Scrarf/PCB_For_FPGA_Path_Tracer/readme.md

# Work in progress!

PCB for [FPGA\_Path\_tracer](https://github.com/Scrarf/FPGA_Path_Tracer).

# Schematic

schematic

# Layout (WIP)

schematic
