Scrarf/PCB_For_FPGA_Path_Tracer/fpga_board.kicad_pcb

## KiCad design fpga_board.kicad_pcb (2026-03-17)

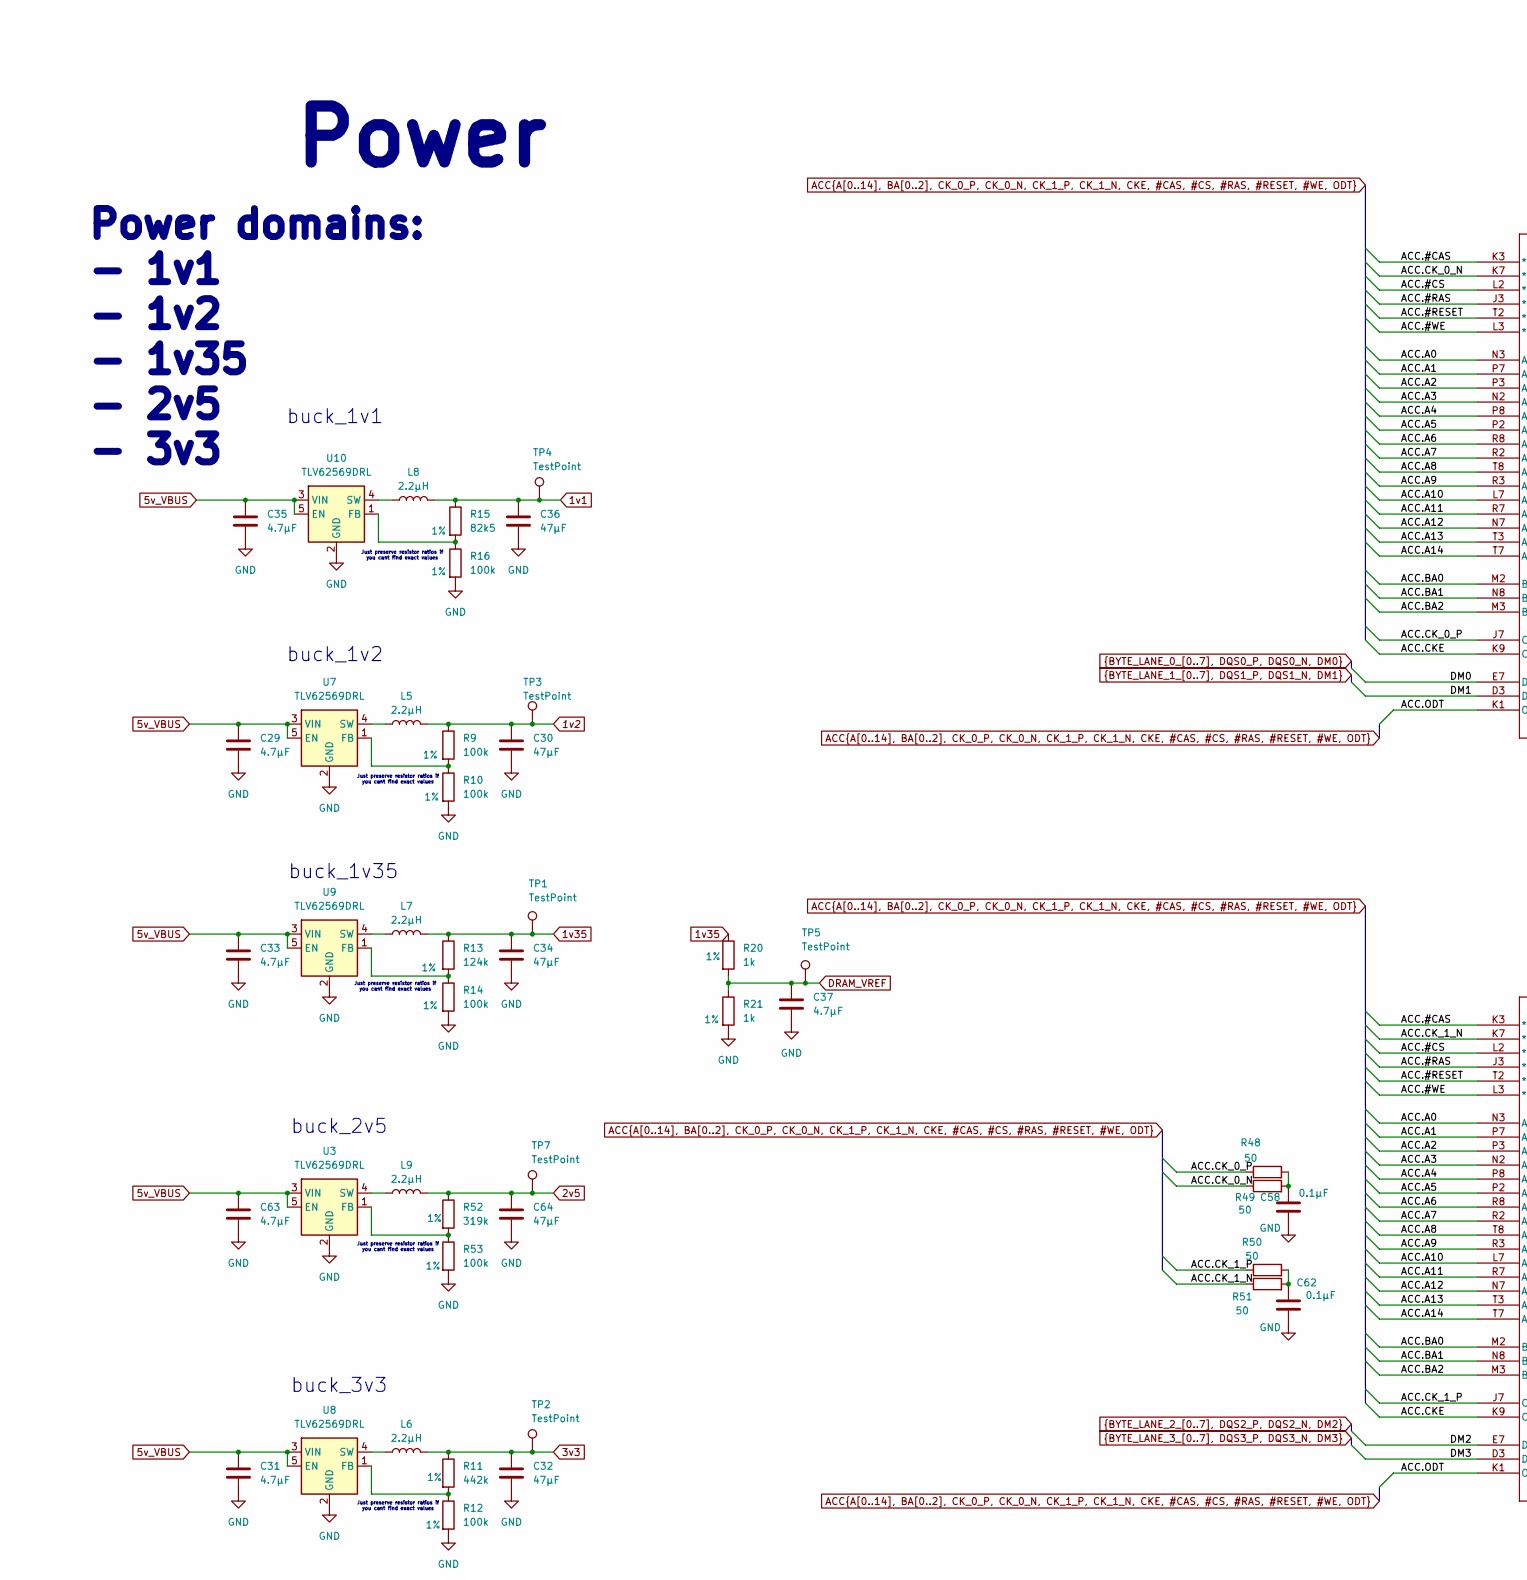
[picture p1: schematic fpga_board.kicad_sch, part in row 1, column 1]

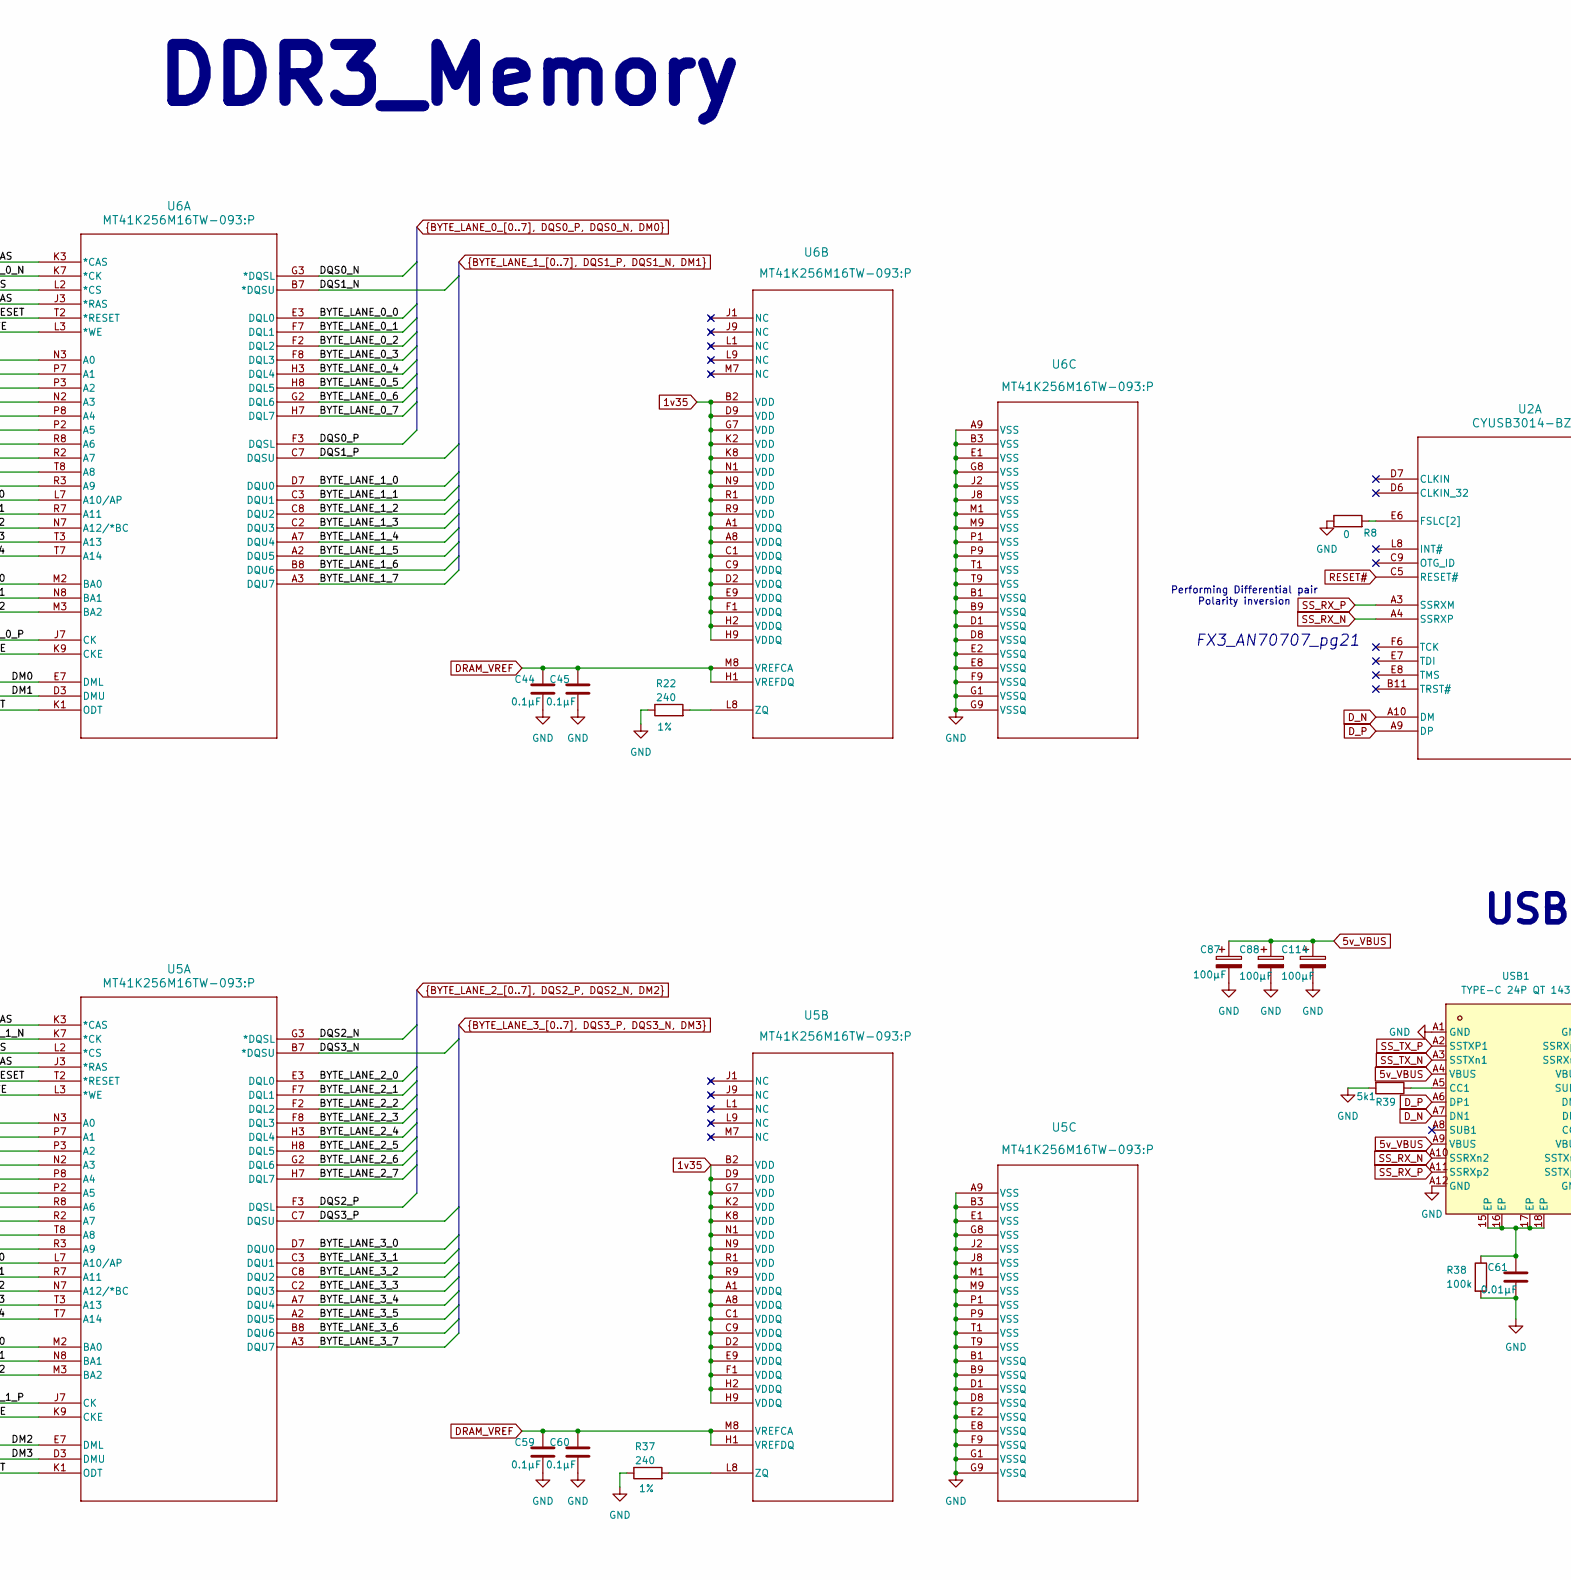
[picture p2: schematic fpga_board.kicad_sch, part in row 1, column 2]

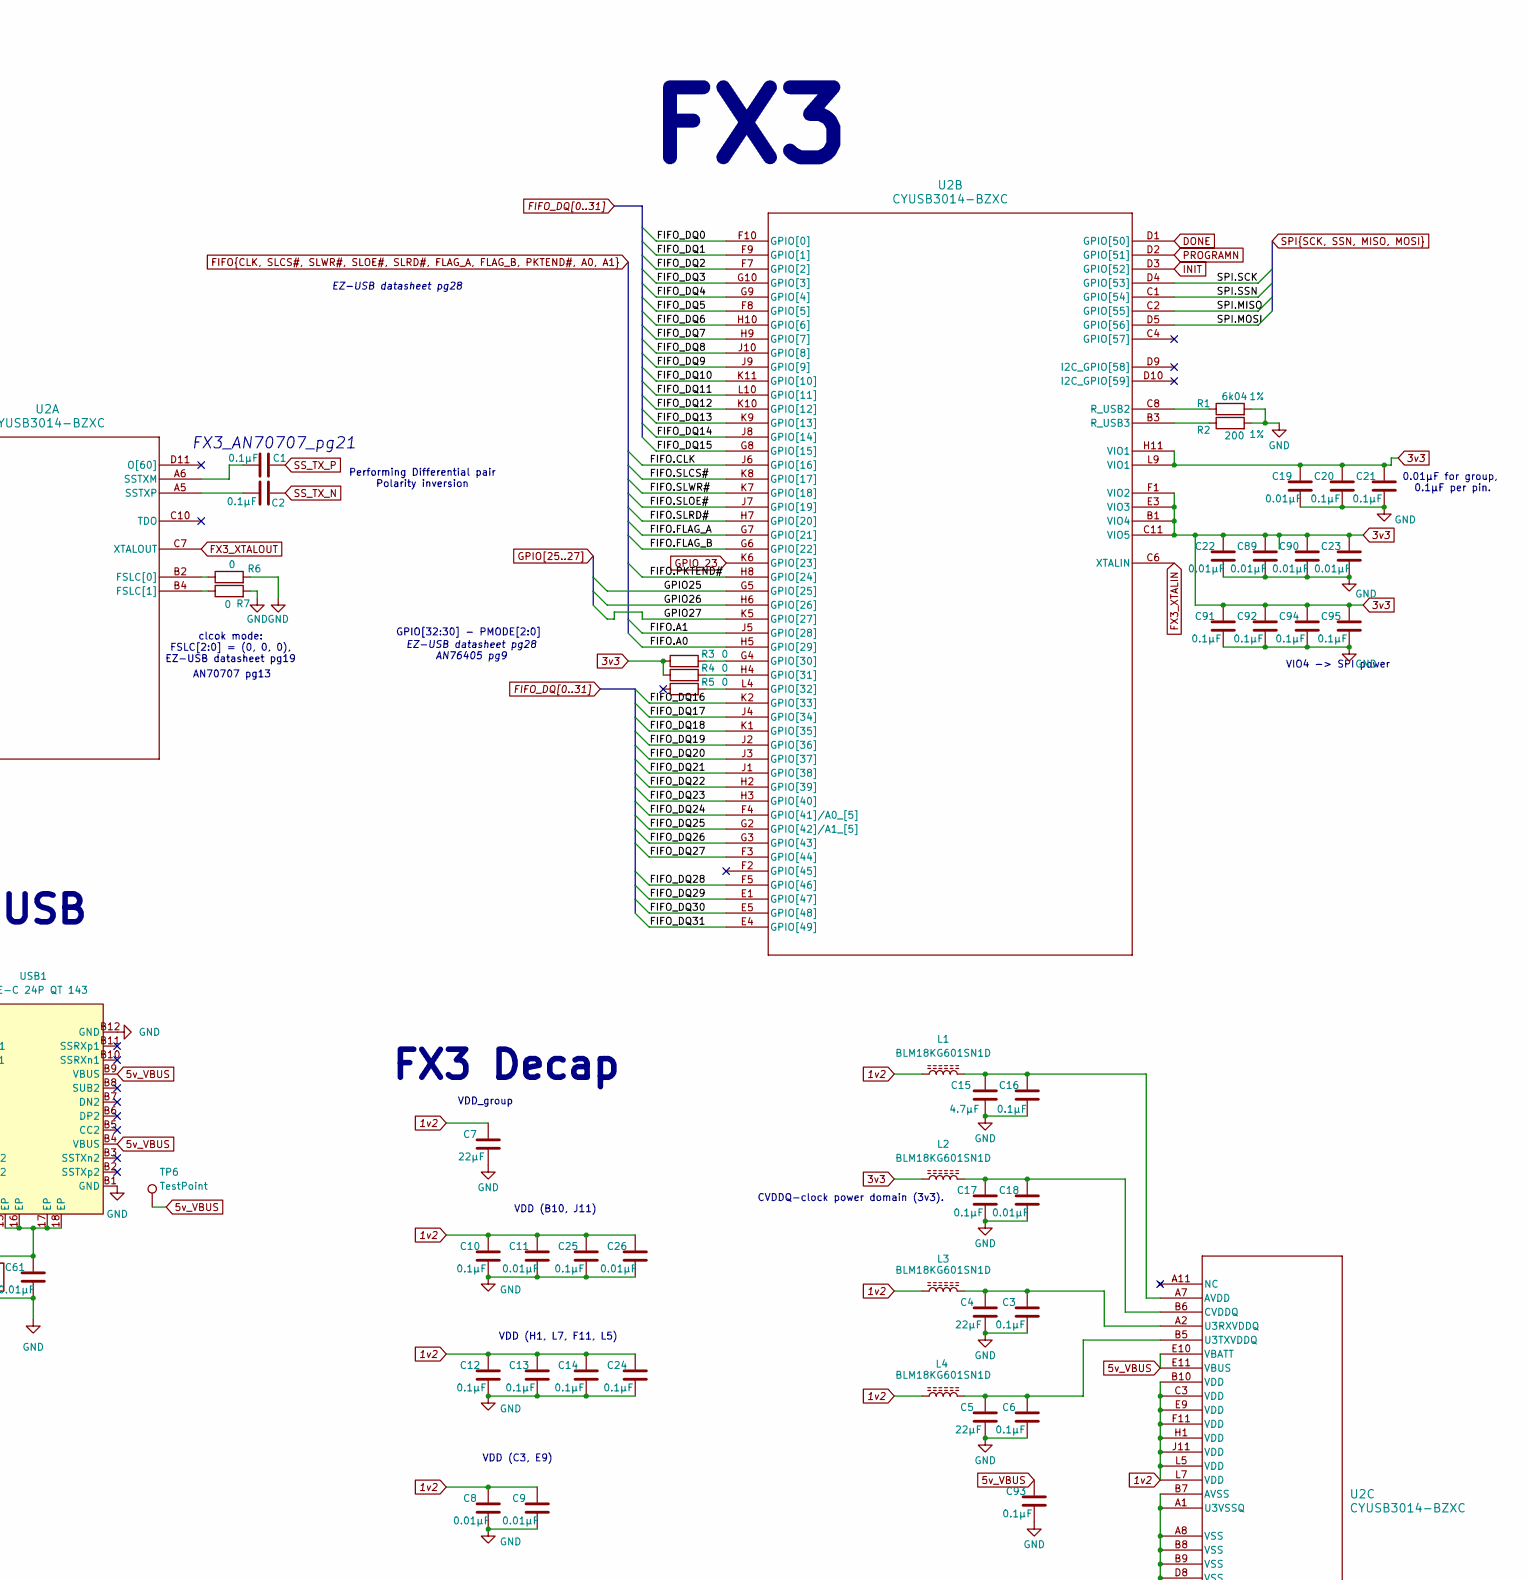
[picture p3: schematic fpga_board.kicad_sch, part in row 1, column 3]

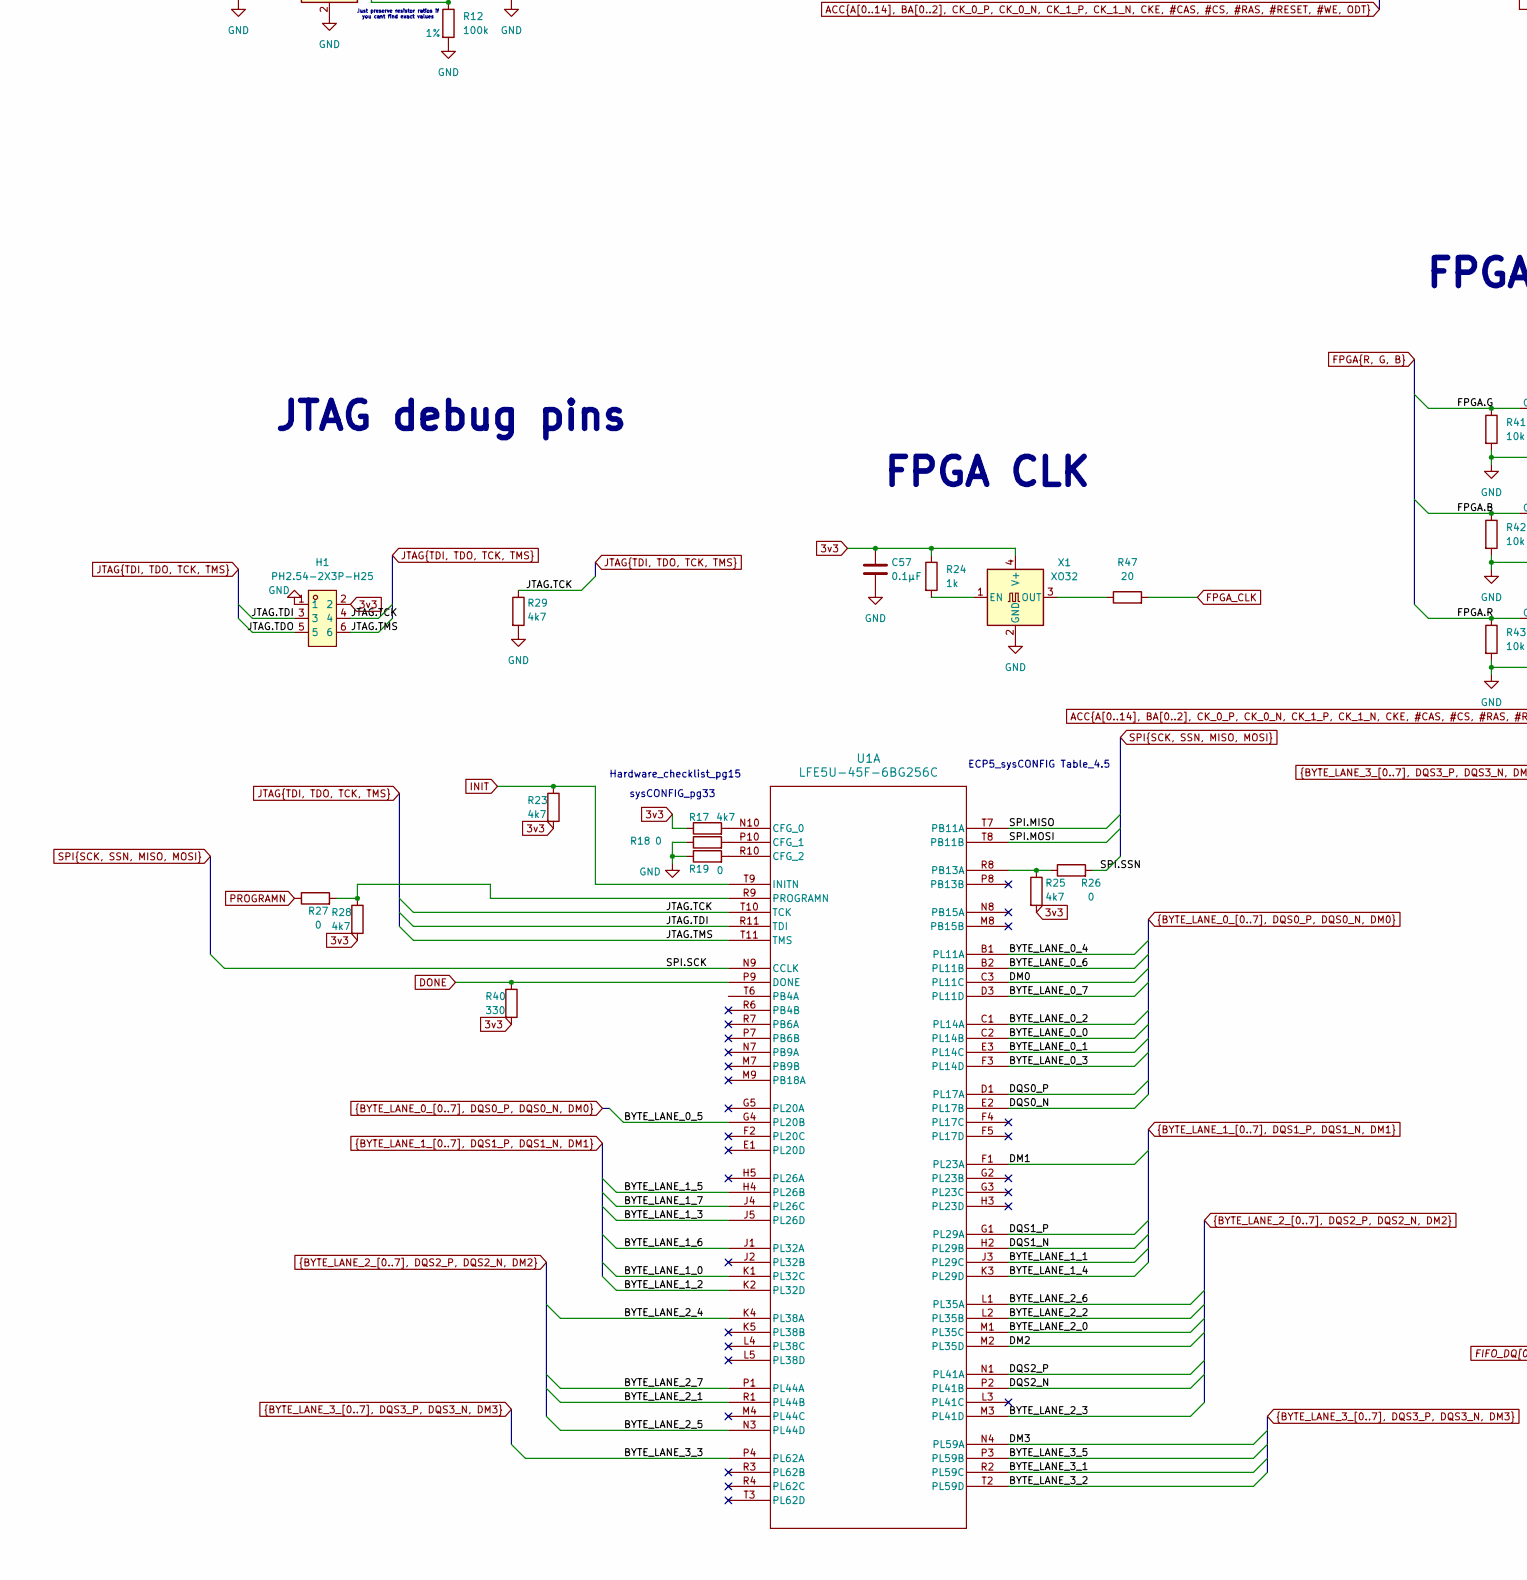
[picture p4: schematic fpga_board.kicad_sch, part in row 2, column 1]

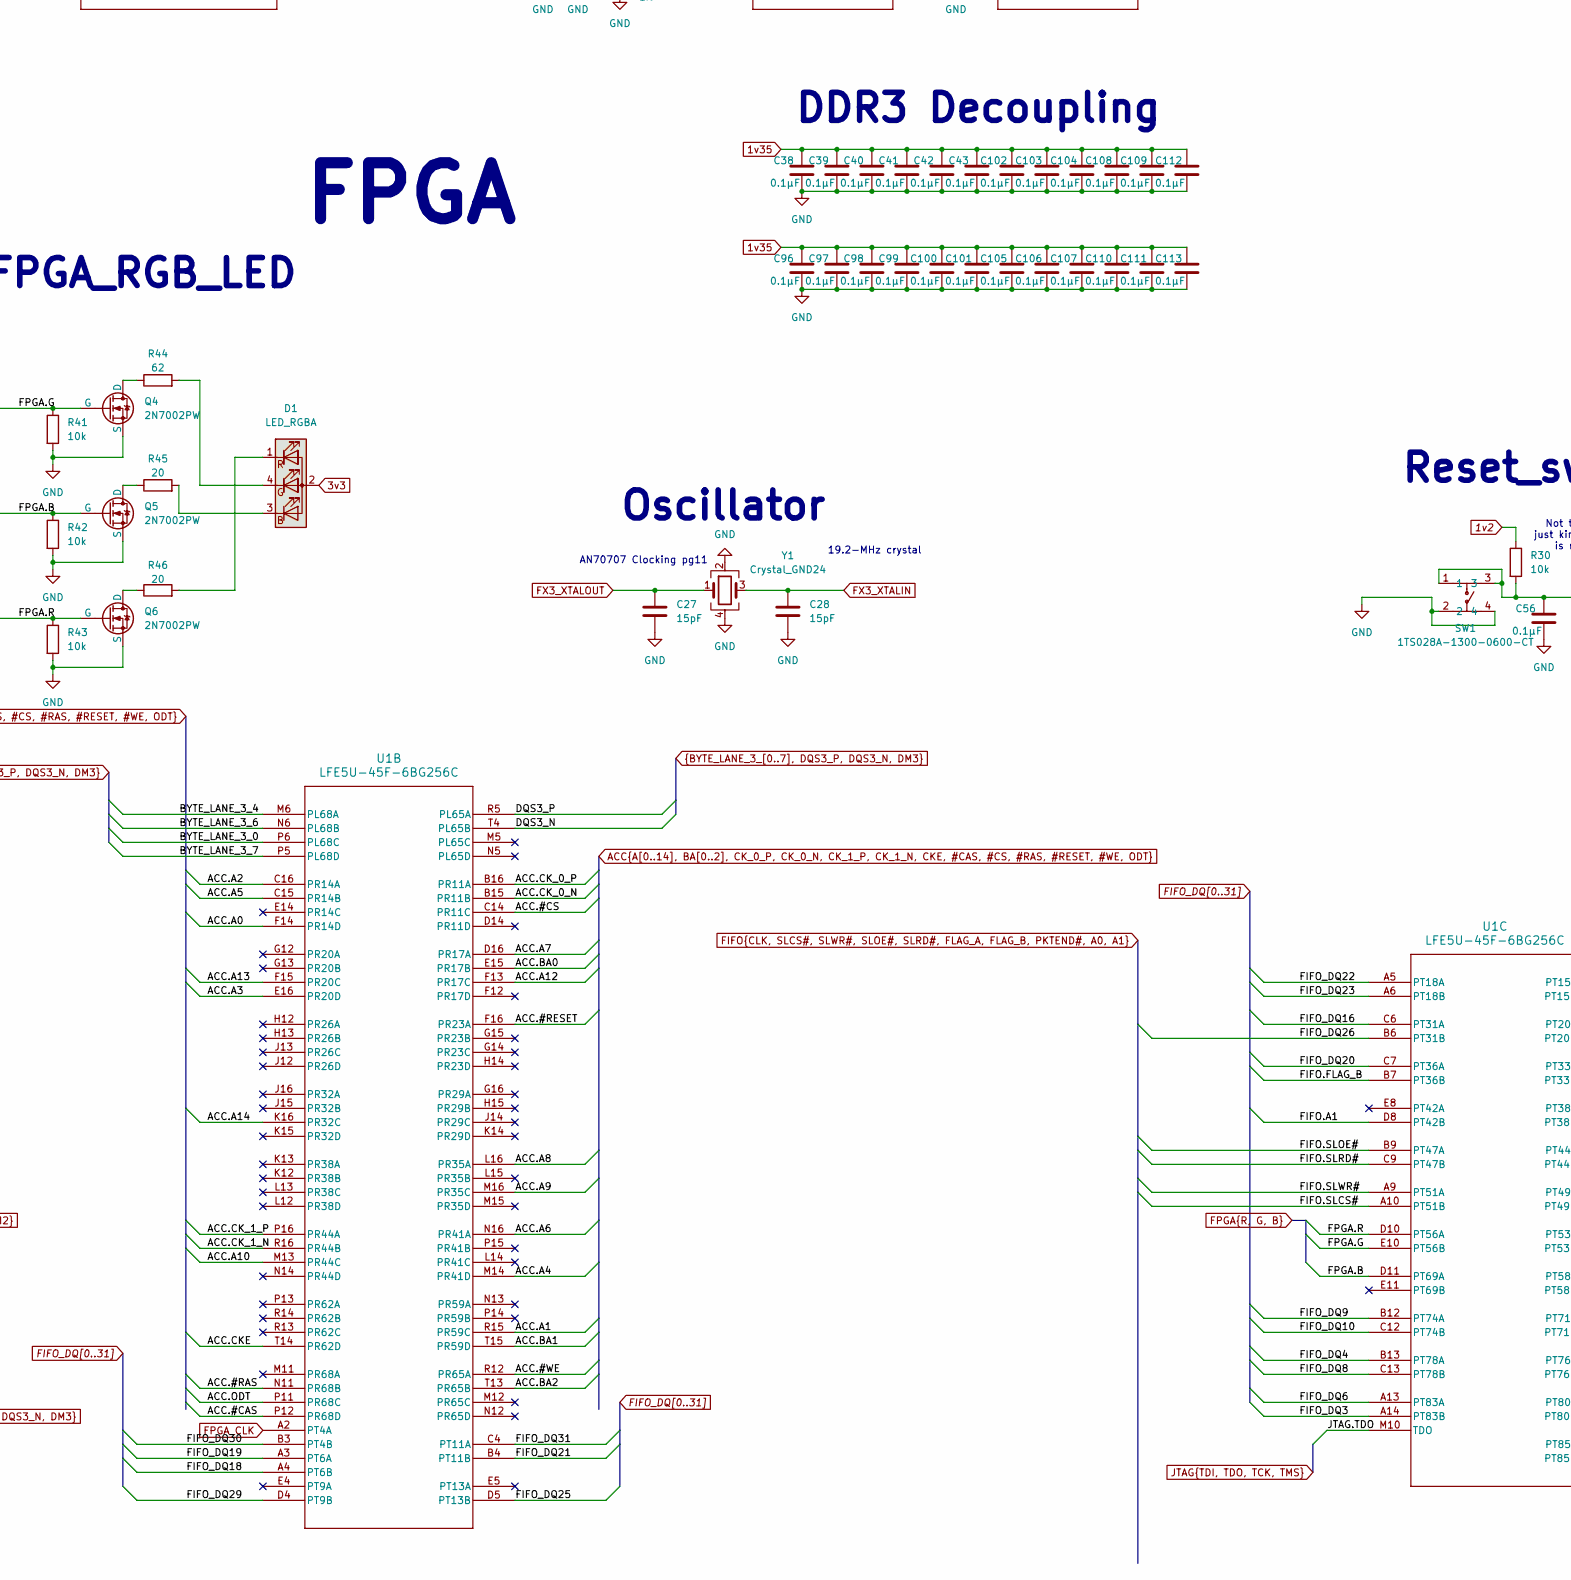
[picture p5: schematic fpga_board.kicad_sch, part in row 2, column 2]

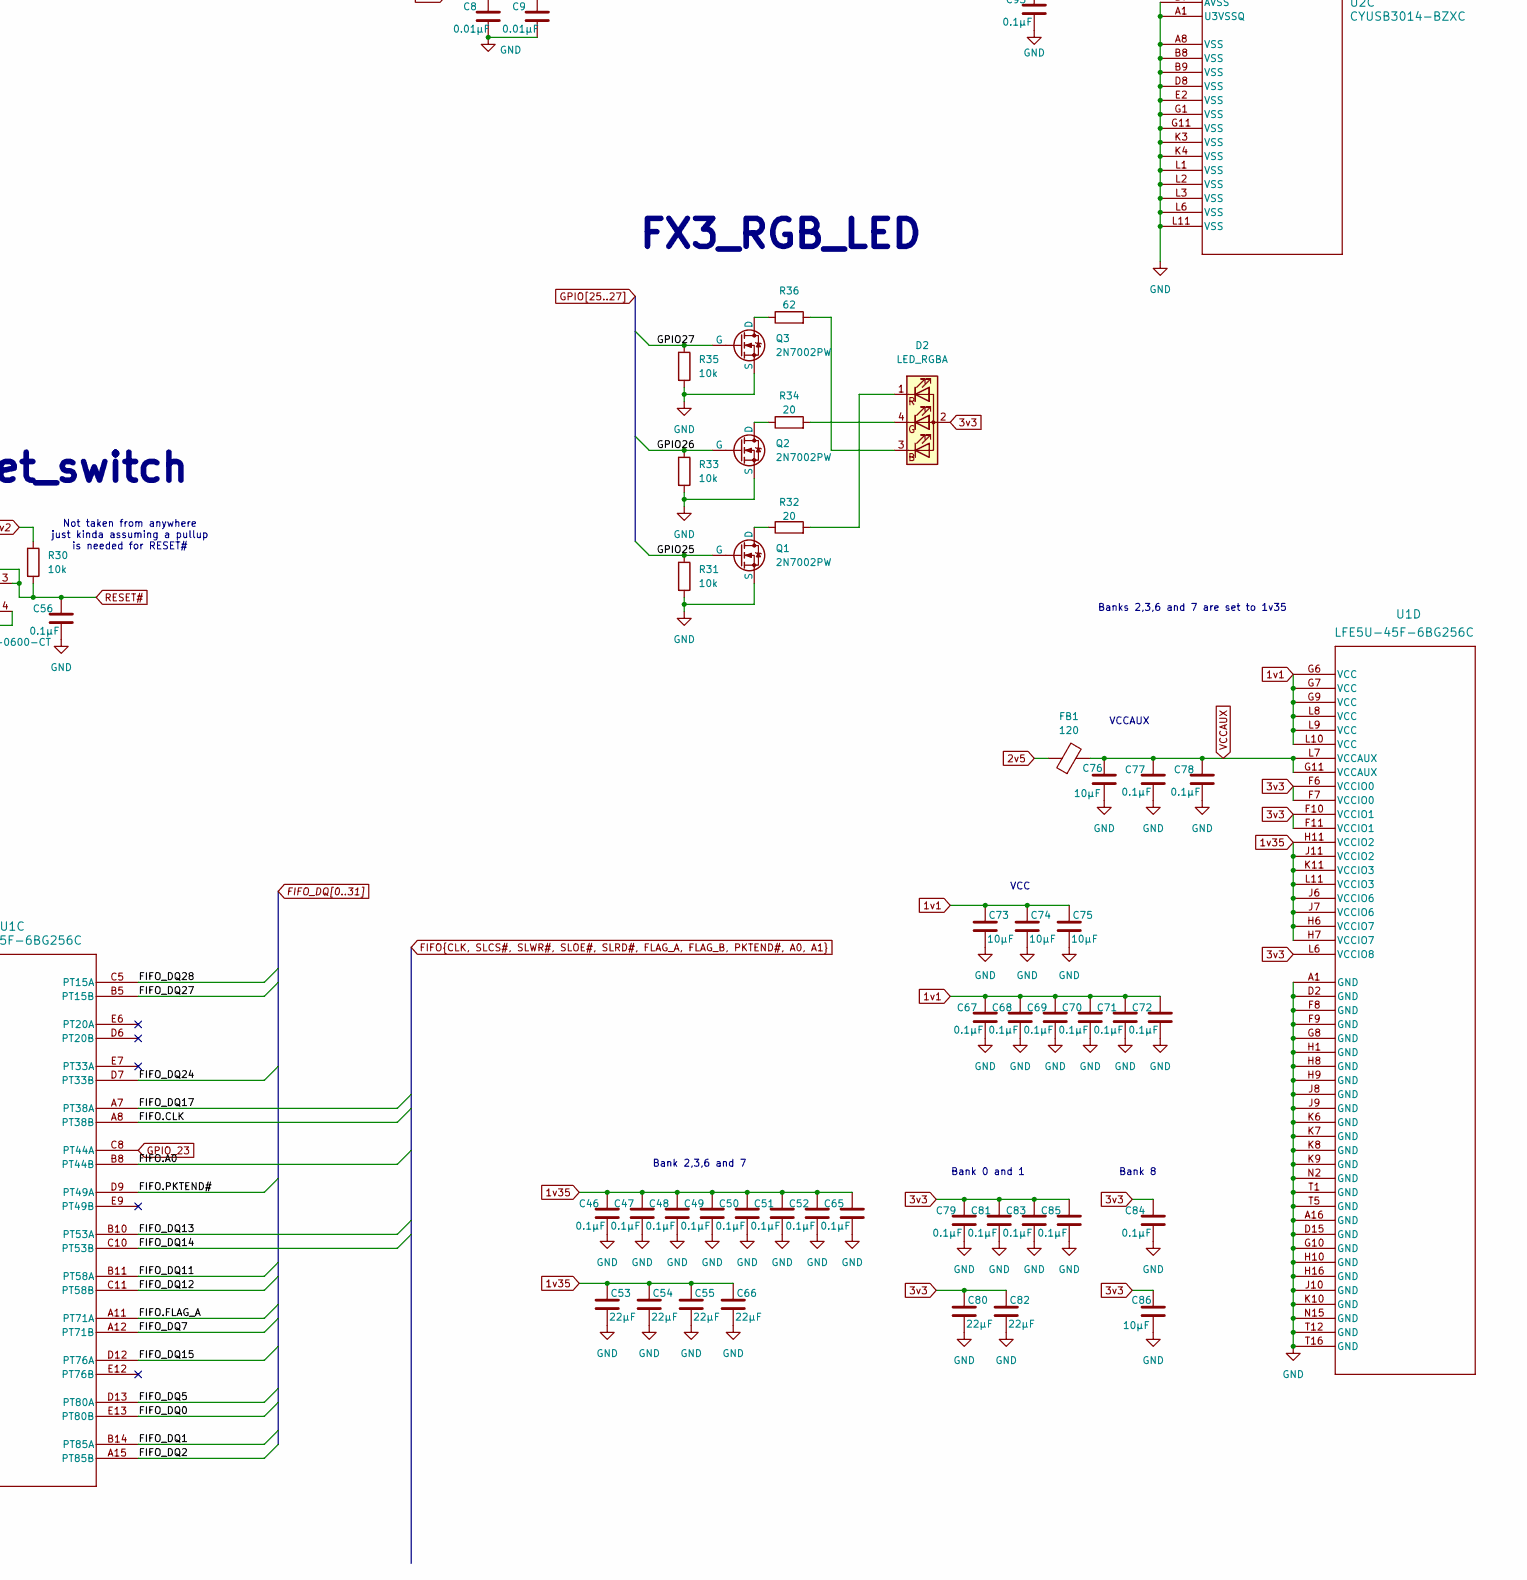
[picture p6: schematic fpga_board.kicad_sch, part in row 2, column 3]

Parts:
C1, C2, C3, C6, C10, C12, C13, C14, C16, C17, C20, C21, C24, C25, C38, C39, C40, C41, C42, C43, C44, C45, C46, C47, C48, C49, C50, C51, C52, C56, C57, C58, C59, C60, C62, C65, C67, C68, C69, C70, C71, C72, C77, C78, C79, C81, C83, C84, C85, C91, C92, C93, C94, C95, C96, C97, C98, C99, C100, C101, C102, C103, C104, C105, C106, C107, C108, C109, C110, C111, C112, C113: 0.1µF; C_0402_1005Metric; LCSC Part C60474
C4, C5, C7, C53, C54, C55, C66, C80, C82: 22µF; C_0603_1608Metric; LCSC Part C6119868
C8, C9, C11, C18, C19, C22, C23, C26, C61, C89, C90: 0.01µF; C_0402_1005Metric; LCSC Part C22435944
C15, C29, C31, C33, C35, C37, C63: 4.7µF; C_0402_1005Metric; LCSC Part C6119786
C27, C28: 15pF; C_0402_1005Metric; LCSC Part C5448865
C30, C32, C34, C36, C64: 47µF; C_0805_2012Metric; LCSC Part C19103846
C73, C74, C75, C76, C86: 10µF; C_0402_1005Metric; LCSC Part C315248
C87, C88, C114: 100μF; CP_Elec_6.3x5.4; LCSC Part C2887276
D1, D2: LED_RGBA; LED_Wurth_150044M155260; LCSC Part C22461780
FB1: 120; L_0603_1608Metric; LCSC Part C307770
H1: PH2.54-2X3P-H25; HDR-TH_6P-P2.54-V-M-R2-C3-S2.54-1; LCSC Part C42431837
L1, L2, L3, L4: BLM18KG601SN1D; L_0603_1608Metric; LCSC Part C85833
L5, L6, L7, L8, L9: 2.2µH; IND_VLS3015_TDK; LCSC Part C42924311
Q1, Q2, Q3, Q4, Q5, Q6: 2N7002PW; SOT-323_SC-70; LCSC Part C7379955
R1: 6k04; R_0402_1005Metric; LCSC Part C168240
R2: 200; R_0402_1005Metric; LCSC Part C49655161
R3, R4, R5, R6, R7, R8, R18, R19, R26, R27: 0; R_0402_1005Metric; LCSC Part C106231
R9, R10, R12, R14, R16, R38, R53: 100k; R_0603_1608Metric; LCSC Part C14675
R11: 442k; R_0603_1608Metric; LCSC Part C3013201
R13: 124k; R_0603_1608Metric; LCSC Part C3016392
R15: 82k5; R_0603_1608Metric; LCSC Part C2999460
R17, R23, R25, R28, R29: 4k7; R_0402_1005Metric; LCSC Part C3017492
R20, R21, R24: 1k; R_0603_1608Metric; LCSC Part C22548
R22, R37: 240; R_0603_1608Metric; LCSC Part C49653074
R30, R31, R33, R35, R41, R42, R43: 10k; R_0402_1005Metric; LCSC Part C51035904
R32, R34, R45, R46, R47: 20; R_0402_1005Metric; LCSC Part C3017453
R36, R44: 62; R_0402_1005Metric; LCSC Part C49653021
R39: 5k1; R_0402_1005Metric; LCSC Part C49652827
R40: 330; R_0402_1005Metric; LCSC Part C2906929
R48, R49, R50, R51: 50; R_0402_1005Metric; LCSC Part C853312
R52: 319k; R_0603_1608Metric; LCSC Part C20165692
SW1: 1TS028A-1300-0600-CT; SW-SMD_4P-L2.8-W1.9-P1.20-LS3.0_1TS028A; LCSC Part C481983
TP1, TP2, TP3, TP4, TP5, TP6, TP7: TestPoint; TestPoint_Pad_D1.0mm
U1: LFE5U-45F-6BG256C; caBGA256_LAT; LCSC Part C1550834
U2: CYUSB3014-BZXC; TFBGA-121_10x10mm_Layout11x11_P0.8mm; LCSC Part C462526
U3, U7, U8, U9, U10: TLV62569DRL; SOT-563; LCSC Part C163217
U5, U6: MT41K256M16TW-093:P; Micron_FBGA-96_9x14mm_Layout9x16_P0.8mm; LCSC Part C2064402
USB1: TYPE-C 24P QT 143; TYPE-C-SMD_C9900025773; LCSC Part C5156605
X1: XO32; Crystal_SMD_5032-4Pin_5.0x3.2mm; LCSC Part C50345411
Y1: Crystal_GND24; Crystal_SMD_2520-4Pin_2.5x2.0mm; LCSC Part C7206296

Connections:
1v1: C36.1, C67.2, C68.2, C69.2, C70.2, C71.2, C72.2, C73.1, C74.1, C75.1, L8.2, R15.1, TP4.1, U1.G6 (VCC), U1.G7 (VCC), U1.G9 (VCC), U1.L8 (VCC), U1.L9 (VCC), U1.L10 (VCC)
1v2: C7.2, C8.2, C9.2, C10.2, C11.2, C12.2, C13.2, C14.2, C24.2, C25.2, C26.2, C30.1, L1.1, L3.1, L4.1, L5.2, R9.1, R30.1, TP3.1, U2.B10 (VDD), U2.C3 (VDD), U2.E9 (VDD), U2.F11 (VDD), U2.H1 (VDD), U2.J11 (VDD), U2.L5 (VDD), U2.L7 (VDD)
1v35: C34.1, C38.2, C39.2, C40.2, C41.2, C42.2, C43.2, C46.2, C47.2, C48.2, C49.2, C50.2, C51.2, C52.2, C53.1, C54.1, C55.1, C65.2, C66.1, C96.2, C97.2, C98.2, C99.2, C100.2, C101.2, C102.2, C103.2, C104.2, C105.2, C106.2, C107.2, C108.2, C109.2, C110.2, C111.2, C112.2, C113.2, L7.2, R13.1, R20.1, TP1.1, U1.H6 (VCCIO7), U1.H7 (VCCIO7), U1.H11 (VCCIO2), U1.J6 (VCCIO6), U1.J7 (VCCIO6), U1.J11 (VCCIO2), U1.K11 (VCCIO3), U1.L11 (VCCIO3), U5.A1 (VDDQ), U5.A8 (VDDQ), U5.B2 (VDD), U5.C1 (VDDQ), U5.C9 (VDDQ), U5.D2 (VDDQ), U5.D9 (VDD), U5.E9 (VDDQ), U5.F1 (VDDQ), U5.G7 (VDD), U5.H2 (VDDQ), U5.H9 (VDDQ), U5.K2 (VDD), U5.K8 (VDD), U5.N1 (VDD), U5.N9 (VDD), U5.R1 (VDD), U5.R9 (VDD), U6.A1 (VDDQ), U6.A8 (VDDQ), U6.B2 (VDD), U6.C1 (VDDQ), U6.C9 (VDDQ), U6.D2 (VDDQ), U6.D9 (VDD), U6.E9 (VDDQ), U6.F1 (VDDQ), U6.G7 (VDD), U6.H2 (VDDQ), U6.H9 (VDDQ), U6.K2 (VDD), U6.K8 (VDD), U6.N1 (VDD), U6.N9 (VDD), U6.R1 (VDD), U6.R9 (VDD)
2v5: C64.1, FB1.1, L9.2, R52.1, TP7.1
3v3: C19.2, C20.2, C21.2, C22.2, C23.2, C32.1, C57.1, C79.2, C80.1, C81.2, C82.1, C83.2, C84.2, C85.2, C86.1, C89.2, C90.2, C91.2, C92.2, C94.2, C95.2, D1.2 (A), D2.2 (A), H1.2, L2.1, L6.2, R3.1, R4.1, R11.1, R17.1, R23.2, R24.1, R25.2, R28.2, R40.2, TP2.1, U1.F6 (VCCIO0), U1.F7 (VCCIO0), U1.F10 (VCCIO1), U1.F11 (VCCIO1), U1.L6 (VCCIO8), U2.B1 (VIO4), U2.C11 (VIO5), U2.E3 (VIO3), U2.F1 (VIO2), U2.H11 (VIO1), U2.L9 (VIO1), X1.4 (V+)
5v_VBUS: C29.1, C31.1, C33.1, C35.1, C63.1, C87.1, C88.1, C93.2, C114.1, TP6.1, U2.E10 (VBATT), U2.E11 (VBUS), U3.3 (VIN), U3.5 (EN), U7.3 (VIN), U7.5 (EN), U8.3 (VIN), U8.5 (EN), U9.3 (VIN), U9.5 (EN), U10.3 (VIN), U10.5 (EN), USB1.A4 (VBUS), USB1.A9 (VBUS), USB1.B4 (VBUS), USB1.B9 (VBUS)
ACC.#CAS: U1.P12 (PR68D), U5.K3 (*CAS), U6.K3 (*CAS)
ACC.#CS: U1.C14 (PR11C), U5.L2 (*CS), U6.L2 (*CS)
ACC.#RAS: U1.N11 (PR68B), U5.J3 (*RAS), U6.J3 (*RAS)
ACC.#RESET: U1.F16 (PR23A), U5.T2 (*RESET), U6.T2 (*RESET)
ACC.#WE: U1.R12 (PR65A), U5.L3 (*WE), U6.L3 (*WE)
ACC.A0: U1.F14 (PR14D), U5.N3 (A0), U6.N3 (A0)
ACC.A1: U1.R15 (PR59C), U5.P7 (A1), U6.P7 (A1)
ACC.A2: U1.C16 (PR14A), U5.P3 (A2), U6.P3 (A2)
ACC.A3: U1.E16 (PR20D), U5.N2 (A3), U6.N2 (A3)
ACC.A4: U1.M14 (PR41D), U5.P8 (A4), U6.P8 (A4)
ACC.A5: U1.C15 (PR14B), U5.P2 (A5), U6.P2 (A5)
ACC.A6: U1.N16 (PR41A), U5.R8 (A6), U6.R8 (A6)
ACC.A7: U1.D16 (PR17A), U5.R2 (A7), U6.R2 (A7)
ACC.A8: U1.L16 (PR35A), U5.T8 (A8), U6.T8 (A8)
ACC.A9: U1.M16 (PR35C), U5.R3 (A9), U6.R3 (A9)
ACC.A10: U1.M13 (PR44C), U5.L7 (A10/AP), U6.L7 (A10/AP)
ACC.A11: U5.R7 (A11), U6.R7 (A11)
ACC.A12: U1.F13 (PR17C), U5.N7 (A12/*BC), U6.N7 (A12/*BC)
ACC.A13: U1.F15 (PR20C), U5.T3 (A13), U6.T3 (A13)
ACC.A14: U1.K16 (PR32C), U5.T7 (A14), U6.T7 (A14)
ACC.BA0: U1.E15 (PR17B), U5.M2 (BA0), U6.M2 (BA0)
ACC.BA1: U1.T15 (PR59D), U5.N8 (BA1), U6.N8 (BA1)
ACC.BA2: U1.T13 (PR65B), U5.M3 (BA2), U6.M3 (BA2)
ACC.CKE: U1.T14 (PR62D), U5.K9 (CKE), U6.K9 (CKE)
ACC.CK_0_N: R49.1, U1.B15 (PR11B), U6.K7 (*CK)
ACC.CK_0_P: R48.1, U1.B16 (PR11A), U6.J7 (CK)
ACC.CK_1_N: R51.1, U1.R16 (PR44B), U5.K7 (*CK)
ACC.CK_1_P: R50.1, U1.P16 (PR44A), U5.J7 (CK)
ACC.ODT: U1.P11 (PR68C), U5.K1 (ODT), U6.K1 (ODT)
BYTE_LANE_0_0: U1.C2 (PL14B), U6.E3 (DQL0)
BYTE_LANE_0_1: U1.E3 (PL14C), U6.F7 (DQL1)
BYTE_LANE_0_2: U1.C1 (PL14A), U6.F2 (DQL2)
BYTE_LANE_0_3: U1.F3 (PL14D), U6.F8 (DQL3)
BYTE_LANE_0_4: U1.B1 (PL11A), U6.H3 (DQL4)
BYTE_LANE_0_5: U1.G4 (PL20B), U6.H8 (DQL5)
BYTE_LANE_0_6: U1.B2 (PL11B), U6.G2 (DQL6)
BYTE_LANE_0_7: U1.D3 (PL11D), U6.H7 (DQL7)
BYTE_LANE_1_0: U1.K1 (PL32C), U6.D7 (DQU0)
BYTE_LANE_1_1: U1.J3 (PL29C), U6.C3 (DQU1)
BYTE_LANE_1_2: U1.K2 (PL32D), U6.C8 (DQU2)
BYTE_LANE_1_3: U1.J5 (PL26D), U6.C2 (DQU3)
BYTE_LANE_1_4: U1.K3 (PL29D), U6.A7 (DQU4)
BYTE_LANE_1_5: U1.H4 (PL26B), U6.A2 (DQU5)
BYTE_LANE_1_6: U1.J1 (PL32A), U6.B8 (DQU6)
BYTE_LANE_1_7: U1.J4 (PL26C), U6.A3 (DQU7)
BYTE_LANE_2_0: U1.M1 (PL35C), U5.E3 (DQL0)
BYTE_LANE_2_1: U1.R1 (PL44B), U5.F7 (DQL1)
BYTE_LANE_2_2: U1.L2 (PL35B), U5.F2 (DQL2)
BYTE_LANE_2_3: U1.M3 (PL41D), U5.F8 (DQL3)
BYTE_LANE_2_4: U1.K4 (PL38A), U5.H3 (DQL4)
BYTE_LANE_2_5: U1.N3 (PL44D), U5.H8 (DQL5)
BYTE_LANE_2_6: U1.L1 (PL35A), U5.G2 (DQL6)
BYTE_LANE_2_7: U1.P1 (PL44A), U5.H7 (DQL7)
BYTE_LANE_3_0: U1.P6 (PL68C), U5.D7 (DQU0)
BYTE_LANE_3_1: U1.R2 (PL59C), U5.C3 (DQU1)
BYTE_LANE_3_2: U1.T2 (PL59D), U5.C8 (DQU2)
BYTE_LANE_3_3: U1.P4 (PL62A), U5.C2 (DQU3)
BYTE_LANE_3_4: U1.M6 (PL68A), U5.A7 (DQU4)
BYTE_LANE_3_5: U1.P3 (PL59B), U5.A2 (DQU5)
BYTE_LANE_3_6: U1.N6 (PL68B), U5.B8 (DQU6)
BYTE_LANE_3_7: U1.P5 (PL68D), U5.A3 (DQU7)
DM0: U1.C3 (PL11C), U6.E7 (DML)
DM1: U1.F1 (PL23A), U6.D3 (DMU)
DM2: U1.M2 (PL35D), U5.E7 (DML)
DM3: U1.N4 (PL59A), U5.D3 (DMU)
DONE: R40.1, U1.P9 (DONE), U2.D1 (GPIO[50])
DQS0_N: U1.E2 (PL17B), U6.G3 (*DQSL)
DQS0_P: U1.D1 (PL17A), U6.F3 (DQSL)
DQS1_N: U1.H2 (PL29B), U6.B7 (*DQSU)
DQS1_P: U1.G1 (PL29A), U6.C7 (DQSU)
DQS2_N: U1.P2 (PL41B), U5.G3 (*DQSL)
DQS2_P: U1.N1 (PL41A), U5.F3 (DQSL)
DQS3_N: U1.T4 (PL65B), U5.B7 (*DQSU)
DQS3_P: U1.R5 (PL65A), U5.C7 (DQSU)
DRAM_VREF: C37.1, C44.2, C45.2, C59.2, C60.2, R20.2, R21.1, TP5.1, U5.H1 (VREFDQ), U5.M8 (VREFCA), U6.H1 (VREFDQ), U6.M8 (VREFCA)
D_N: U2.A10 (DM), USB1.A7 (DN1)
D_P: U2.A9 (DP), USB1.A6 (DP1)
FIFO.A0: U1.B8 (PT44B), U2.H5 (GPIO[29])
FIFO.A1: U1.D8 (PT42B), U2.J5 (GPIO[28])
FIFO.CLK: U1.A8 (PT38B), U2.J6 (GPIO[16])
FIFO.FLAG_A: U1.A11 (PT71A), U2.G7 (GPIO[21])
FIFO.FLAG_B: U1.B7 (PT36B), U2.G6 (GPIO[22])
FIFO.PKTEND#: U1.D9 (PT49A), U2.H8 (GPIO[24])
FIFO.SLCS#: U1.A10 (PT51B), U2.K8 (GPIO[17])
FIFO.SLOE#: U1.B9 (PT47A), U2.J7 (GPIO[19])
FIFO.SLRD#: U1.C9 (PT47B), U2.H7 (GPIO[20])
FIFO.SLWR#: U1.A9 (PT51A), U2.K7 (GPIO[18])
FIFO_DQ0: U1.E13 (PT80B), U2.F10 (GPIO[0])
FIFO_DQ1: U1.B14 (PT85A), U2.F9 (GPIO[1])
FIFO_DQ2: U1.A15 (PT85B), U2.F7 (GPIO[2])
FIFO_DQ3: U1.A14 (PT83B), U2.G10 (GPIO[3])
FIFO_DQ4: U1.B13 (PT78A), U2.G9 (GPIO[4])
FIFO_DQ5: U1.D13 (PT80A), U2.F8 (GPIO[5])
FIFO_DQ6: U1.A13 (PT83A), U2.H10 (GPIO[6])
FIFO_DQ7: U1.A12 (PT71B), U2.H9 (GPIO[7])
FIFO_DQ8: U1.C13 (PT78B), U2.J10 (GPIO[8])
FIFO_DQ9: U1.B12 (PT74A), U2.J9 (GPIO[9])
FIFO_DQ10: U1.C12 (PT74B), U2.K11 (GPIO[10])
FIFO_DQ11: U1.B11 (PT58A), U2.L10 (GPIO[11])
FIFO_DQ12: U1.C11 (PT58B), U2.K10 (GPIO[12])
FIFO_DQ13: U1.B10 (PT53A), U2.K9 (GPIO[13])
FIFO_DQ14: U1.C10 (PT53B), U2.J8 (GPIO[14])
FIFO_DQ15: U1.D12 (PT76A), U2.G8 (GPIO[15])
FIFO_DQ16: U1.C6 (PT31A), U2.K2 (GPIO[33])
FIFO_DQ17: U1.A7 (PT38A), U2.J4 (GPIO[34])
FIFO_DQ18: U1.A4 (PT6B), U2.K1 (GPIO[35])
FIFO_DQ19: U1.A3 (PT6A), U2.J2 (GPIO[36])
FIFO_DQ20: U1.C7 (PT36A), U2.J3 (GPIO[37])
FIFO_DQ21: U1.B4 (PT11B), U2.J1 (GPIO[38])
FIFO_DQ22: U1.A5 (PT18A), U2.H2 (GPIO[39])
FIFO_DQ23: U1.A6 (PT18B), U2.H3 (GPIO[40])
FIFO_DQ24: U1.D7 (PT33B), U2.F4 (GPIO[41]/A0_[5])
FIFO_DQ25: U1.D5 (PT13B), U2.G2 (GPIO[42]/A1_[5])
FIFO_DQ26: U1.B6 (PT31B), U2.G3 (GPIO[43])
FIFO_DQ27: U1.B5 (PT15B), U2.F3 (GPIO[44])
FIFO_DQ28: U1.C5 (PT15A), U2.F5 (GPIO[46])
FIFO_DQ29: U1.D4 (PT9B), U2.E1 (GPIO[47])
FIFO_DQ30: U1.B3 (PT4B), U2.E5 (GPIO[48])
FIFO_DQ31: U1.C4 (PT11A), U2.E4 (GPIO[49])
FPGA.B: Q5.2 (G), R42.1, U1.D11 (PT69A)
FPGA.G: Q4.2 (G), R41.1, U1.E10 (PT56B)
FPGA.R: Q6.2 (G), R43.1, U1.D10 (PT56A)
FPGA_CLK: R47.2, U1.A2 (PT4A)
FX3_XTALIN: C28.1, U2.C6 (XTALIN), Y1.3
FX3_XTALOUT: C27.1, U2.C7 (XTALOUT), Y1.1
GND: C3.1, C4.1, C5.1, C6.1, C7.1, C8.1, C9.1, C10.1, C11.1, C12.1, C13.1, C14.1, C15.2, C16.1, C17.1, C18.1, C19.1, C20.1, C21.1, C22.1, C23.1, C24.1, C25.1, C26.1, C27.2, C28.2, C29.2, C30.2, C31.2, C32.2, C33.2, C34.2, C35.2, C36.2, C37.2, C38.1, C39.1, C40.1, C41.1, C42.1, C43.1, C44.1, C45.1, C46.1, C47.1, C48.1, C49.1, C50.1, C51.1, C52.1, C53.2, C54.2, C55.2, C56.1, C57.2, C58.1, C59.1, C60.1, C61.1, C62.1, C63.2, C64.2, C65.1, C66.2, C67.1, C68.1, C69.1, C70.1, C71.1, C72.1, C73.2, C74.2, C75.2, C76.2, C77.1, C78.1, C79.1, C80.2, C81.1, C82.2, C83.1, C84.1, C85.1, C86.2, C87.2, C88.2, C89.1, C90.1, C91.1, C92.1, C93.1, C94.1, C95.1, C96.1, C97.1, C98.1, C99.1, C100.1, C101.1, C102.1, C103.1, C104.1, C105.1, C106.1, C107.1, C108.1, C109.1, C110.1, C111.1, C112.1, C113.1, C114.2, H1.1, Q1.3 (S), Q2.3 (S), Q3.3 (S), Q4.3 (S), Q5.3 (S), Q6.3 (S), R1.2, R2.2, R6.2, R7.2, R8.1, R10.2, R12.2, R14.2, R16.2, R18.1, R19.1, R21.2, R22.1, R29.2, R31.2, R33.2, R35.2, R37.1, R38.2, R39.2, R41.2, R42.2, R43.2, R53.2, SW1.2, SW1.4, U1.A1 (GND), U1.A16 (GND), U1.D2 (GND), U1.D15 (GND), U1.F8 (GND), U1.F9 (GND), U1.G8 (GND), U1.G10 (GND), U1.H1 (GND), U1.H8 (GND), U1.H9 (GND), U1.H10 (GND), U1.H16 (GND), U1.J8 (GND), U1.J9 (GND), U1.J10 (GND), U1.K6 (GND), U1.K7 (GND), U1.K8 (GND), U1.K9 (GND), U1.K10 (GND), U1.N2 (GND), U1.N15 (GND), U1.T1 (GND), U1.T5 (GND), U1.T12 (GND), U1.T16 (GND), U2.A1 (U3VSSQ), U2.A8 (VSS), U2.B7 (AVSS), U2.B8 (VSS), U2.B9 (VSS), U2.D8 (VSS), U2.E2 (VSS), U2.G1 (VSS), U2.G11 (VSS), U2.K3 (VSS), U2.K4 (VSS), U2.L1 (VSS), U2.L2 (VSS), U2.L3 (VSS), U2.L6 (VSS), U2.L11 (VSS), U3.2 (GND), U5.A9 (VSS), U5.B1 (VSSQ), U5.B3 (VSS), U5.B9 (VSSQ), U5.D1 (VSSQ), U5.D8 (VSSQ), U5.E1 (VSS), U5.E2 (VSSQ), U5.E8 (VSSQ), U5.F9 (VSSQ), U5.G1 (VSSQ), U5.G8 (VSS), U5.G9 (VSSQ), U5.J2 (VSS), U5.J8 (VSS), U5.M1 (VSS), U5.M9 (VSS), U5.P1 (VSS), U5.P9 (VSS), U5.T1 (VSS), U5.T9 (VSS), U6.A9 (VSS), U6.B1 (VSSQ), U6.B3 (VSS), U6.B9 (VSSQ), U6.D1 (VSSQ), U6.D8 (VSSQ), U6.E1 (VSS), U6.E2 (VSSQ), U6.E8 (VSSQ), U6.F9 (VSSQ), U6.G1 (VSSQ), U6.G8 (VSS), U6.G9 (VSSQ), U6.J2 (VSS), U6.J8 (VSS), U6.M1 (VSS), U6.M9 (VSS), U6.P1 (VSS), U6.P9 (VSS), U6.T1 (VSS), U6.T9 (VSS), U7.2 (GND), U8.2 (GND), U9.2 (GND), U10.2 (GND), USB1.A1 (GND), USB1.A12 (GND), USB1.B1 (GND), USB1.B12 (GND), X1.2 (GND), Y1.2, Y1.4
GPIO25: Q1.2 (G), R31.1, U2.G5 (GPIO[25])
GPIO26: Q2.2 (G), R33.1, U2.H6 (GPIO[26])
GPIO27: Q3.2 (G), R35.1, U2.K5 (GPIO[27])
GPIO_23: U1.C8 (PT44A), U2.K6 (GPIO[23])
INIT: R23.1, U1.T9 (INITN), U2.D3 (GPIO[52])
JTAG.TCK: H1.4, R29.1, U1.T10 (TCK)
JTAG.TDI: H1.3, U1.R11 (TDI)
JTAG.TDO: H1.5, U1.M10 (TDO)
JTAG.TMS: H1.6, U1.T11 (TMS)
unnamed: C58.2, R48.2, R49.2
unnamed: C61.2, R38.1, USB1.15 (EP), USB1.16 (EP), USB1.17 (EP), USB1.18 (EP)
unnamed: C62.2, R50.2, R51.2
unnamed: D1.3 (BK), R45.2
unnamed: D1.4 (GK), R44.2
unnamed: D1.1 (RK), R46.2
unnamed: D2.3 (BK), R36.2
unnamed: D2.4 (GK), R34.2
unnamed: D2.1 (RK), R32.2
unnamed: Q1.1 (D), R32.1
unnamed: Q2.1 (D), R34.1
unnamed: Q3.1 (D), R36.1
unnamed: Q4.1 (D), R44.1
unnamed: Q5.1 (D), R45.1
unnamed: Q6.1 (D), R46.1
unnamed: R17.2, U1.N10 (CFG_0)
unnamed: R18.2, U1.P10 (CFG_1)
unnamed: R19.2, U1.R10 (CFG_2)
unnamed: R25.1, R26.1, U1.R8 (PB13A)
unnamed: R27.2, R28.1, U1.R9 (PROGRAMN)
unnamed: R6.1, U2.B2 (FSLC[0])
unnamed: R7.1, U2.B4 (FSLC[1])
unnamed: R8.2, U2.E6 (FSLC[2])
unnamed: C1.1, U2.A6 (SSTXM)
unnamed: C2.1, U2.A5 (SSTXP)
unnamed: R3.2, U2.G4 (GPIO[30])
unnamed: R4.2, U2.H4 (GPIO[31])
unnamed: R5.2, U2.L4 (GPIO[32])
unnamed: R1.1, U2.C8 (R_USB2)
unnamed: R2.1, U2.B3 (R_USB3)
unnamed: C15.1, C16.2, L1.2, U2.A7 (AVDD)
unnamed: C17.2, C18.2, L2.2, U2.B6 (CVDDQ)
unnamed: C3.2, C4.2, L3.2, U2.A2 (U3RXVDDQ)
unnamed: C5.2, C6.2, L4.2, U2.B5 (U3TXVDDQ)
unnamed: R52.2, R53.1, U3.1 (FB)
unnamed: L9.1, U3.4 (SW)
unnamed: R37.2, U5.L8 (ZQ)
unnamed: R22.2, U6.L8 (ZQ)
unnamed: R9.2, R10.1, U7.1 (FB)
unnamed: L5.1, U7.4 (SW)
unnamed: R11.2, R12.1, U8.1 (FB)
unnamed: L6.1, U8.4 (SW)
unnamed: R13.2, R14.1, U9.1 (FB)
unnamed: L7.1, U9.4 (SW)
unnamed: R15.2, R16.1, U10.1 (FB)
unnamed: L8.1, U10.4 (SW)
unnamed: R39.1, USB1.A5 (CC1)
unnamed: R24.2, X1.1 (EN)
unnamed: R47.1, X1.3 (OUT)
PROGRAMN: R27.1, U2.D2 (GPIO[51])
RESET#: C56.2, R30.2, SW1.1, SW1.3, U2.C5 (RESET#)
SPI.MISO: U1.T7 (PB11A), U2.C2 (GPIO[55])
SPI.MOSI: U1.T8 (PB11B), U2.D5 (GPIO[56])
SPI.SCK: U1.N9 (CCLK), U2.D4 (GPIO[53])
SPI.SSN: R26.2, U2.C1 (GPIO[54])
SS_RX_N: U2.A4 (SSRXP), USB1.A10 (SSRXn2)
SS_RX_P: U2.A3 (SSRXM), USB1.A11 (SSRXp2)
SS_TX_N: C2.2, USB1.A3 (SSTXn1)
SS_TX_P: C1.2, USB1.A2 (SSTXP1)
VCCAUX: C76.1, C77.2, C78.2, FB1.2, U1.G11 (VCCAUX), U1.L7 (VCCAUX)

Notes on the sheet:
VDD (C3, E9)
GPIO[32:30] - PMODE[2:0]
Banks 2,3,6 and 7 are set to 1v35
Performing Differential pair Polarity inversion
Power
clcok mode: FSLC[2:0] = (0, 0, 0), EZ-USB datasheet pg19
Just preserve resistor ratios if you cant find exact values
VCCAUX
buck_1v35
buck_2v5
AN70707 pg13
VDD (B10, J11)
FPGA_RGB_LED
FX3
VCC
DDR3 Decoupling
VDD_group
buck_1v2
VDD (H1, L7, F11, L5)
19.2-MHz crystal
buck_1v1
FPGA CLK
buck_3v3
FX3 Decap
Not taken from anywhere just kinda assuming a pullup is needed for RESET#
Hardware_checklist_pg15
Bank 0 and 1
AN70707 Clocking pg11
0.01µF for group, 0.1µF per pin.
USB
EZ-USB datasheet pg28 AN76405 pg9
Bank 8
DDR3_Memory
sysCONFIG_pg33
Bank 2,3,6 and 7
Oscillator
ECP5_sysCONFIG Table_4.5
FX3_AN70707_pg21
FX3_RGB_LED
FPGA
Power domains: - 1v1 - 1v2 - 1v35 - 2v5 - 3v3
JTAG debug pins
EZ-USB datasheet pg28
VIO4 -> SPI power
CVDDQ-clock power domain (3v3).
Reset_switch

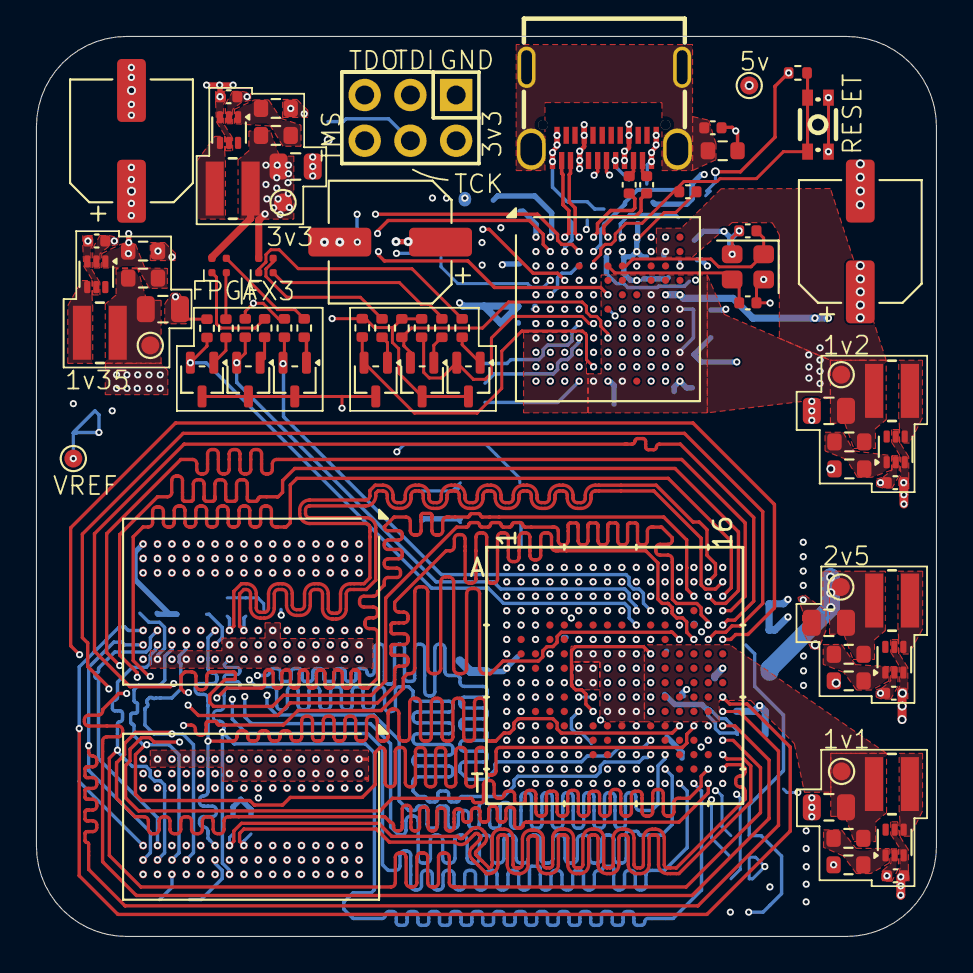
[picture p7: board fpga_board.kicad_pcb from above]

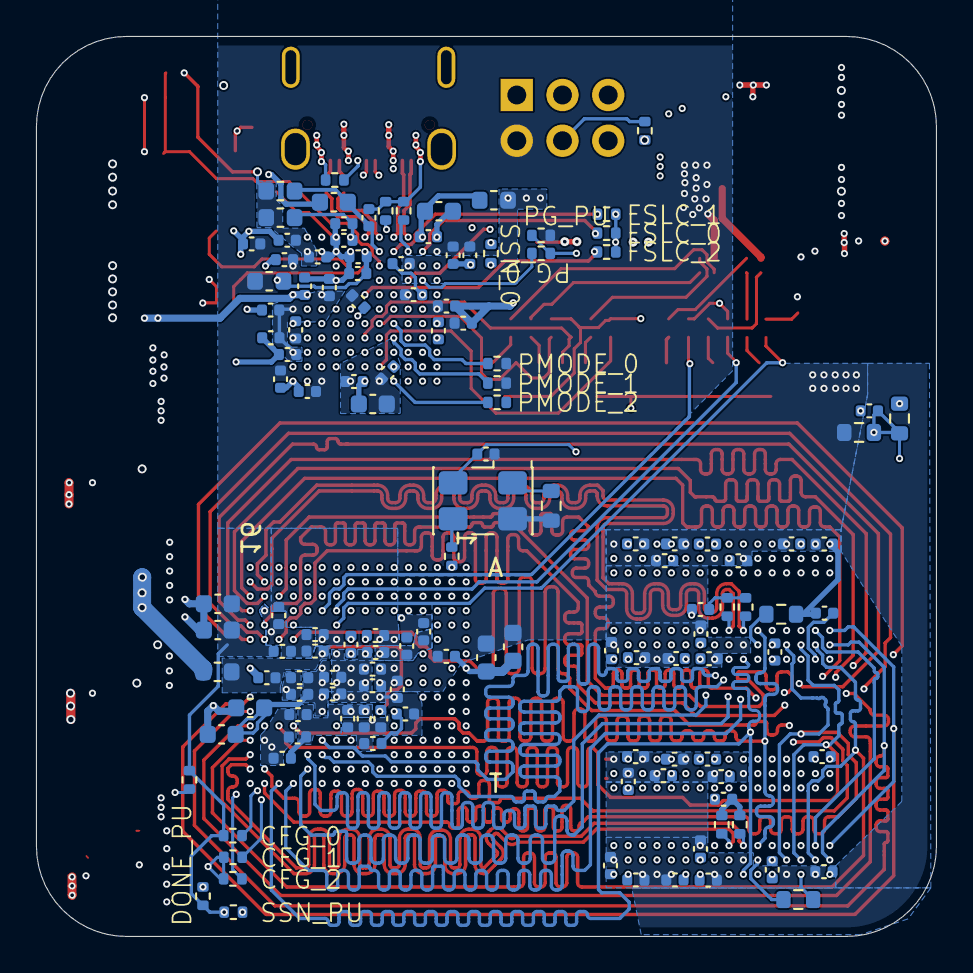
[picture p8: board fpga_board.kicad_pcb from below]

Board: 8 copper layers, 50.0 x 50.0 mm, 206 parts (130 on the bottom side), 201 nets.
