Scrarf/PCB_For_FPGA_Path_Tracer/(commit log)

2025-10-25 changed FPGA to 45k cuz old one went out of stock :(
    [fpga_board.kicad_pcb, fpga_board.kicad_sch]
2025-10-25 DQ lane busses are assigned to apropriate DQS lanes and ready
    [fpga_board.kicad_sch]
2025-10-25 DQ and DQS group busses complete
    [FPGA-SC-02034-3-0-ECP5U-45-Pinout - Highspeed DQS and DQ pinouts.csv, fpga_board.kicad_sch]
2025-10-27 removed DQS groups instead added DDR3 pin busses
    [fpga_board.kicad_sch]
2025-10-27 added colors and bunch of other stuff idk
    [fpga_board.kicad_pcb, fpga_board.kicad_sch]
2025-10-30 ddr wiring and other stuff
    [fpga_board.kicad_pcb, fpga_board.kicad_sch]
2025-11-01 layer 3 FX3 length matched
    [fpga_board.kicad_pcb, fpga_board.kicad_sch]
2025-11-02 minor changes
    [fpga_board.kicad_pcb, fpga_board.kicad_sch]
2025-11-08 changed stackup
    [fpga_board.kicad_pcb]
2025-11-21 added FPGA oscillator
    [fpga_board.kicad_sch]
2025-11-22 added SPI connections and FX3 RGB LED. Decided to go with 2 dram chips instead for 4 for 32bit bus
    [fpga_board.kicad_sch]
2025-12-06 added spi pins and FX3 crystal capacitors and allat and idk other stuff
    [fpga_board.kicad_pcb, fpga_board.kicad_sch]
2025-12-06 added capacitor and resistor footprints
    [fpga_board.kicad_pcb, fpga_board.kicad_sch]
2025-12-09 added RGB LED for FPGA, added termintaion to FPGA crystal
    [fpga_board.kicad_pcb, fpga_board.kicad_sch]
2025-12-11 update to kicad 9.0.6 and other changes
    [fpga_board.kicad_pcb, fpga_board.kicad_sch]
2025-12-13 added LCSC footprint libraries
2025-12-13 finished schematic, finished BOM.
    [fpga_board.kicad_pcb, fpga_board.kicad_sch]
2025-12-13 added pre-commit for schematic svg generation, edited readme, organized schematic.
    [fpga_board.kicad_pcb, fpga_board.kicad_sch]
2025-12-13 added layout svg to readme
    [fpga_board.kicad_pcb]
2025-12-15 layout: buck converters placed
    [fpga_board.kicad_pcb, fpga_board.kicad_sch]
2025-12-18 BYTE_LANE 0 and 1 routed and length matched to DDR memory
    [fpga_board.kicad_pcb, fpga_board.kicad_sch]
2025-12-20 all DDR byte lanes routed and length matched
    [fpga_board.kicad_pcb, fpga_board.kicad_sch]
2025-12-23 trying to set up EM simulation for DDR DQ lanes
    [Substrate.stl, Traces_reduced.stl, fpga_board.kicad_pcb]
2025-12-27 moved EM simulation part to a different repo
    [Substrate.stl, Traces_reduced.stl]
2025-12-28 fill zone clearences decreased and .glb exported again
    [fpga_board.kicad_pcb]
2026-01-30 migration from windows to linux, also ACC pins partially finished
    [FPGA-SC-02034-3-0-ECP5U-45-Pinout - Highspeed DQS and DQ pinouts.csv, fpga_board.kicad_pcb, fpga_board.kicad_sch]
2026-01-30 organized ACC clock DDR. not fully routed yet
    [fpga_board.kicad_pcb, fpga_board.kicad_sch]
2026-02-02 ACC F.Cu routed and length matched
    [fpga_board.kicad_pcb, fpga_board.kicad_sch]
2026-02-02 ACC pins completed.
    [fpga_board.kicad_pcb, fpga_board.kicad_sch]
2026-02-03 added 2v5 buck converter
    [fpga_board.kicad_pcb, fpga_board.kicad_sch]
2026-02-07 FIFO_DQ and FIFO_CTRL lanes routed and length matched
    [fpga_board.kicad_pcb, fpga_board.kicad_sch]
2026-02-08 USB 2.0 and USB 3.0 routed. UBS 3.0 Differential pair polarity reversed
    [fpga_board.kicad_pcb, fpga_board.kicad_sch]
2026-02-12 wired DRAM_VREF including divider and decaps, also wired SPI program pins from FX3 to FPGA
    [fpga_board.kicad_pcb, fpga_board.kicad_sch]
2026-02-12 fpga active oscillator pin changed and layout fully constructed. B.Cu ACC lines slightly modified and FPGA fifo lanes slightly modified to free GPLL input pin
    [fpga_board.kicad_pcb, fpga_board.kicad_sch]
2026-02-12 oscillator core voltage fixed. changed from 1v35 to 3v3.
    [fpga_board.kicad_pcb, fpga_board.kicad_sch]
2026-02-12 2v5 and 1v1 wired but needs power integrity tests
    [fpga_board.kicad_pcb]
2026-02-15 added FX3 RGB in layout. wired 1v2 FX3 core. wired DONE pullup.
    [fpga_board.kicad_pcb, fpga_board.kicad_sch]
2026-02-15 updated DDR3 footprint BGA diameter from 0.4mm to 0.45mm for better stability I guess?
    [fpga_board.kicad_pcb, fpga_board.kicad_sch]
2026-02-15 updated FX3 footprint to remove warning
    [fpga_board.kicad_pcb]
2026-02-19 ZQ resistors added to layout
    [fpga_board.kicad_pcb]
2026-02-21 added correct decoupling in schematic for FPGA, currently working on layout.
    [fpga_board.kicad_pcb, fpga_board.kicad_sch]
2026-02-23 FPGA decoupling capacitors finished
    [fpga_board.kicad_pcb, fpga_board.kicad_sch]
2026-02-23 organizing configuration resistors on layout
    [fpga_board.kicad_pcb]
2026-02-24 cleared footprint booard and library missmatch warnings
    [fpga_board.kicad_pcb]
2026-02-25 rearanged RGB LEDs, added 3D models for most components, Added Electrolytic capacitors for VBUS, changed position of JTAG pins and other minor details
    [fpga_board.kicad_pcb, fpga_board.kicad_sch]
2026-02-25 removed unused silkscreens
    [fpga_board.kicad_pcb]
2026-02-26 added kiri to .gitignore. changed FX3 configuration resistor position.
    [fpga_board.kicad_pcb]
2026-02-26 added FX3 decaps (no power yet).
    [fpga_board.kicad_pcb, fpga_board.kicad_sch]
2026-02-28 FX decoupling and power finished
    [fpga_board.kicad_pcb, fpga_board.kicad_sch]
2026-02-28 fixed ACC length matching on B.Cu and F.Cu.
    [fpga_board.kicad_pcb, fpga_board.kicad_sch]
2026-03-01 DDR3 decoupling finished.
    [fpga_board.kicad_pcb, fpga_board.kicad_sch]
2026-03-02 cosmetic siklscreen changes and moved some footprints for better silkscreen availability. Added another 0 ohm resistor for PMODE (PMODE_2). Labeled configuration resistors.
    [fpga_board.kicad_pcb, fpga_board.kicad_sch]
2026-03-02 Added Another 100μF capacitor because I have empty space why not plus it looks cooler
    [fpga_board.kicad_pcb, fpga_board.kicad_sch]
2026-03-03 fixed some errors with JLCDFM
    [fpga_board.kicad_pcb]
2026-03-03 changed some component values to reduce BOM cost, updated sheets for out of stock components.
    [fpga_board.kicad_pcb, fpga_board.kicad_sch]
2026-03-03 Switched VREF testpoint to F.Cu and removed Testpoints from BOM
    [fpga_board.kicad_pcb, fpga_board.kicad_sch]
2026-03-03 moved layout to page center for no reason
    [fpga_board.kicad_pcb]
2026-03-05 added propper BOM.csv, added NC signs on unconnected pins.
    [BOM.csv, fpga_board.kicad_pcb, fpga_board.kicad_sch]
2026-03-05 included gerber in from .gitignore
    [fpga_board-B_Cu.gbr, fpga_board-B_Mask.gbr, fpga_board-B_Paste.gbr, fpga_board-B_Silkscreen.gbr, fpga_board-Edge_Cuts.gbr, fpga_board-F_Cu.gbr, fpga_board-F_Mask.gbr, fpga_board-F_Paste.gbr]
2026-03-07 changed buck converter output capacitors from 10 to 47 microfarad.
    [BOM.csv, fpga_board.kicad_pcb, fpga_board.kicad_sch]
2026-03-07 updated gerber files
    [fpga_board-B_Adhesive.gbr, fpga_board-B_Cu.gbr, fpga_board-B_Mask.gbr, fpga_board-B_Paste.gbr, fpga_board-B_Silkscreen.gbr, fpga_board-Edge_Cuts.gbr, fpga_board-F_Adhesive.gbr, fpga_board-F_Cu.gbr]
2026-03-11 BOM.csv updated 200ohm resistor went out of stock
    [BOM.csv, fpga_board.kicad_pcb, fpga_board.kicad_sch]
2026-03-17 Final commit before production
    [fpga_board-B_Adhesive.gbr, fpga_board-B_Cu.gbr, fpga_board-B_Mask.gbr, fpga_board-B_Paste.gbr, fpga_board-B_Silkscreen.gbr, fpga_board-Edge_Cuts.gbr, fpga_board-F_Adhesive.gbr, fpga_board-F_Cu.gbr]
